BallHamster/ComMANYcator/kicad_bom_export.csv

Generator: | C:\Program Files\KiCad\10.0\bin\scripting\plugins/bom_csv_grouped_by_value_with_fp.py | "" | "" | "" | "" | "" | ""
Component Count: | 41 | "" | "" | "" | "" | "" | ""
Ref | Qnty | Value | Cmp name | Footprint | Description | Vendor | DNP
C1 | 1 | 3,3nF | C | Capacitor_THT:C_Disc_D5.0mm_W2.5mm_P2.50mm | Unpolarized capacitor
C2 | 1 | 10uF | C | Capacitor_THT:CP_Radial_D4.0mm_P2.00mm | Unpolarized capacitor
C3 | 1 | 100nF | C | Capacitor_THT:C_Disc_D5.0mm_W2.5mm_P2.50mm | Unpolarized capacitor
C4 | 1 | 22uF | C | Capacitor_SMD:C_1206_3216Metric | Unpolarized capacitor
C5, C6 | 2 | 4,7 uF | C | Capacitor_THT:CP_Radial_D4.0mm_P2.00mm | Unpolarized capacitor
D1, D2, D3, D4 | 4 | TSAL6100 | TSAL6100 | TSAL6100:LEDRD254W55D595H900 | Infrared (IR) Emitter 940nm 1.35V 100mA 80mW/sr @ 100mA 20° Radial, 5mm Dia (T 1 3/4)
D5, D6 | 2 | TSAL6400 | TSAL6100 | TSAL6100:LEDRD254W55D595H900 | Infrared (IR) Emitter 940nm 1.35V 100mA 80mW/sr @ 100mA 20° Radial, 5mm Dia (T 1 3/4)
J1 | 1 | USB_C_Receptacle_USB2.0_16P | USB_C_Receptacle_USB2.0_16P | Connector_USB:USB_C_Receptacle_HCTL_HC-TYPE-C-16P-01A | USB 2.0-only 16P Type-C Receptacle connector
J2 | 1 | Ext. IR plug | AudioPlug2 | Connector_Audio:Jack_3.5mm_CUI_SJ1-3533NG_Horizontal | Audio Jack, 2 Poles (Mono / TS)
L1 | 1 | 2,2 uH | L | Inductor_SMD:L_Coilcraft_XxL4020 | Inductor
Q1, Q2 | 2 | AO3400A | AO3400A | Package_TO_SOT_SMD:SOT-23 | 30V Vds, 5.7A Id, N-Channel MOSFET, SOT-23
R1, R2, R3, R4, R5, R6, R12 | 7 | 22Ohm | R | Resistor_THT:R_Axial_DIN0207_L6.3mm_D2.5mm_P10.16mm_Horizontal | Resistor
R7 | 1 | 316kOhm | R | Resistor_THT:R_Axial_DIN0207_L6.3mm_D2.5mm_P10.16mm_Horizontal | Resistor
R8, R11, R13 | 3 | 100kOhm | R | Resistor_THT:R_Axial_DIN0207_L6.3mm_D2.5mm_P10.16mm_Horizontal | Resistor
R9, R10 | 2 | 5,1 kOhm | R | Resistor_THT:R_Axial_DIN0207_L6.3mm_D2.5mm_P10.16mm_Horizontal | Resistor
R14, R15 | 2 | 100 Ohm | R | Resistor_THT:R_Axial_DIN0207_L6.3mm_D2.5mm_P10.16mm_Horizontal | Resistor
R16, R17, R18 | 3 | 10 kOhm | R | Resistor_THT:R_Axial_DIN0207_L6.3mm_D2.5mm_P10.16mm_Horizontal | Resistor
U1 | 1 | ESP32-C6-DevKitC-1 | ESP32-C6-DevKitC-1 | PCM_Espressif:ESP32-C6-DevKitC-1 | ESP32-C6-DevKitC-1
U2 | 1 | TSMP58000 | TSMP58000 | OptoDevice:Vishay_MINICAST-3Pin | Photo Module (Amplify&Condition) for PCM Remote Control Systems
U3 | 1 | CC1101 433Mhz module | HW-862_CC1101 | Library:CC1101 RF 433Mhz
U4 | 1 | CC1101 868Mhz module | HW-433_CC1101 | Library:CC1101 RF 833Mhz
U5 | 1 | TSOP38438 | TSOP38438 | OptoDevice:Vishay_MINICAST-3Pin
U6 | 1 | TPS62130 | TPS62130 | Package_DFN_QFN:VQFN-16-1EP_3x3mm_P0.5mm_EP1.68x1.68mm_ThermalVias | 3A Step-Down Converter with DCS-Control, Adjustable Output Voltage, 3-17V Input Voltage, QFN-16
