BallHamster/ComMANYcator/ComMANYcator.kicad_pcb

## KiCad design ComMANYcator.kicad_pcb (2026-10-11)

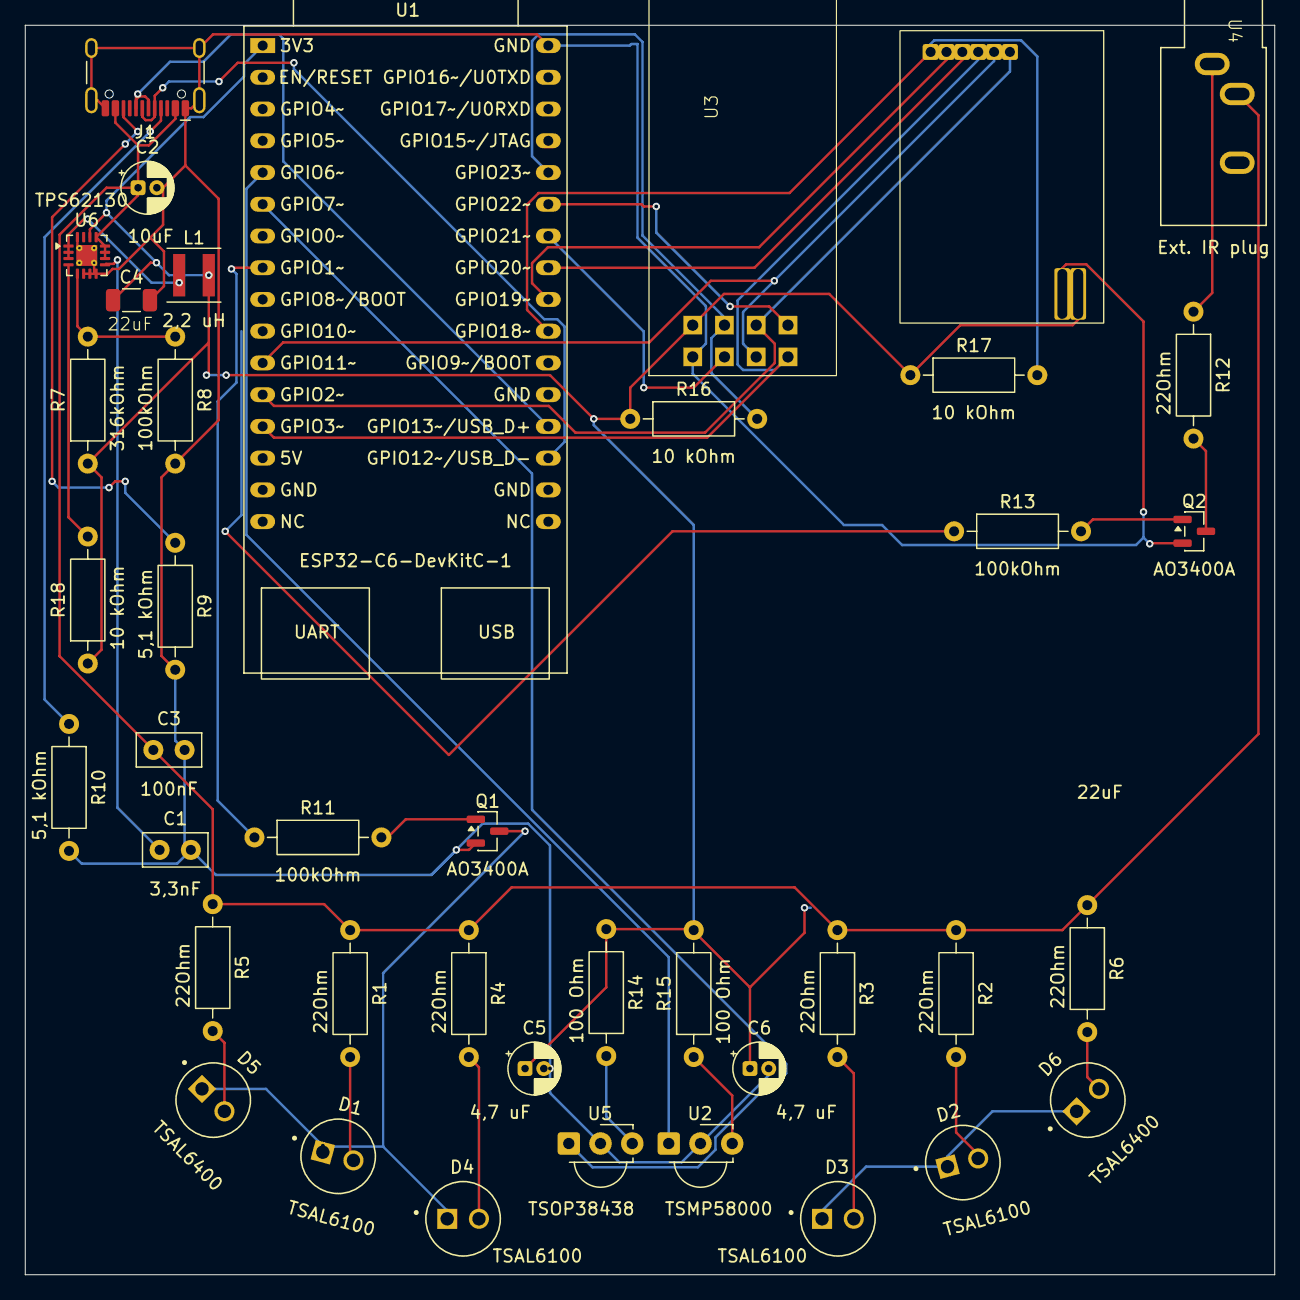
[picture p5: board ComMANYcator.kicad_pcb from above]

Board: 2 copper layers, 100.0 x 100.0 mm, 41 parts (0 on the bottom side), 37 nets.

Parts:
C1: 3,3nF; C_Disc_D5.0mm_W2.5mm_P2.50mm
C2: 10uF; CP_Radial_D4.0mm_P1.50mm
C3: 100nF; C_Disc_D5.0mm_W2.5mm_P2.50mm
C4: 22uF; C_1206_3216Metric
C5, C6: 4,7 uF; CP_Radial_D4.0mm_P1.50mm
D1, D2, D3, D4: TSAL6100; LEDRD254W55D595H900
D5, D6: TSAL6400; LEDRD254W55D595H900
J1: USB_C_Receptacle_USB2.0_16P; USB_C_Receptacle_HCTL_HC-TYPE-C-16P-01A
J2: Ext. IR plug; Jack_3.5mm_CUI_SJ1-3533NG_Horizontal
L1: 2,2 uH; L_Coilcraft_XxL4020
Q1, Q2: AO3400A; SOT-23
R1, R2, R3, R4, R5, R6, R12: 22Ohm; R_Axial_DIN0207_L6.3mm_D2.5mm_P10.16mm_Horizontal
R7: 316kOhm; R_Axial_DIN0207_L6.3mm_D2.5mm_P10.16mm_Horizontal
R8, R11, R13: 100kOhm; R_Axial_DIN0207_L6.3mm_D2.5mm_P10.16mm_Horizontal
R9, R10: 5,1 kOhm; R_Axial_DIN0207_L6.3mm_D2.5mm_P10.16mm_Horizontal
R14, R15: 100 Ohm; R_Axial_DIN0207_L6.3mm_D2.5mm_P10.16mm_Horizontal
R16, R17, R18: 10 kOhm; R_Axial_DIN0207_L6.3mm_D2.5mm_P10.16mm_Horizontal
U1: ESP32-C6-DevKitC-1
U2: TSMP58000; Vishay_MINICAST-3Pin
U3: CC1101 RF 433Mhz
U4: CC1101 RF 833Mhz
U5: TSOP38438; Vishay_MINICAST-3Pin
U6: TPS62130; VQFN-16-1EP_3x3mm_P0.5mm_EP1.68x1.68mm_ThermalVias

Connections:
+3.3V: C4.1, C5.1, C6.1, L1.2, R7.1, R14.1, R15.2, R16.1, R17.1, R18.1, U1.1 (3V3), U3.1 (VCC), U4.7 (VCC), U6.14 (VOS)
+5V: C2.1, C3.1, J1.A4 (VBUS), J1.A9 (VBUS), J1.B4 (VBUS), J1.B9 (VBUS), J2.T, R1.1, R2.1, R3.1, R4.1, R5.1, R6.1, U6.10 (VIN), U6.11 (VIN), U6.12 (VIN), U6.13 (EN)
/MISO: U1.13 (GPIO3), U3.6 (MISO), U4.3 (MISO)
/MOSI: U1.12 (GPIO2), U3.4 (MOSI), U4.1 (MOSI)
/SCK: U1.11 (GPIO11), U3.3 (SCK), U4.2 (SCK)
GND: C1.2, C2.2, C3.2, C4.2, C5.2, C6.2, J1.A1 (GND), J1.A12 (GND), J1.B1 (GND), J1.B12 (GND), J1.SH (SHIELD), Q1.2 (S), Q2.2 (S), R8.2, R9.2, R10.2, U1.32 (GND), U2.2 (GND), U3.5 (GND), U4.8 (GND), U5.2 (GND), U6.6 (GND), U6.7 (FSW), U6.8 (DEF), U6.15 (GND), U6.16 (GND), U6.17 (GND)
unnamed: D1.A, R1.2
unnamed: D2.A, R2.2
unnamed: D3.A, R3.2
unnamed: D4.A, R4.2
unnamed: D5.A, R5.2
unnamed: D6.A, R6.2
unnamed: J1.A5 (CC1), R10.1
unnamed: J1.B5 (CC2), R9.1
unnamed: J2.S, R12.1
unnamed: L1.1, U6.1 (SW), U6.2 (SW), U6.3 (SW)
unnamed: D1.C, D2.C, D3.C, D4.C, D5.C, D6.C, Q1.3 (D)
unnamed: Q1.1 (G), R11.2
unnamed: Q2.3 (D), R12.2
unnamed: Q2.1 (G), R13.2
unnamed: R11.1, U1.8 (GPIO1)
unnamed: U1.5 (GPIO6), U2.1 (OUT)
unnamed: U1.6 (GPIO7), U5.1 (OUT)
unnamed: R13.1, U1.10 (GPIO10)
unnamed: J1.A7 (D-), J1.B7 (D-), U1.19 (GPIO12/USB_D-)
unnamed: J1.A6 (D+), J1.B6 (D+), U1.20 (GPIO13/USB_D+)
unnamed: R17.2, U1.23 (GPIO18), U4.6 (CSN)
unnamed: U1.24 (GPIO19), U4.5 (GDO0)
unnamed: U1.25 (GPIO20), U4.4 (GDO2)
unnamed: U1.26 (GPIO21), U3.7 (GDO0)
unnamed: U1.27 (GPIO22), U3.8 (GDO2)
unnamed: R16.2, U1.28 (GPIO23), U3.2 (CSN)
unnamed: R15.1, U2.3 (Vs)
unnamed: R14.2, U5.3 (VS)
unnamed: R7.2, R8.1, U6.5 (FB)
unnamed: R18.2, U6.4 (PG)
unnamed: C1.1, U6.9 (SS/TR)
