BallHamster/ComMANYcator/(commit log)

2026-10-11 Main push
    [ComMANYcator.kicad_pcb, ComMANYcator.kicad_sch, untitled.csv]
2026-10-11 Update CSV file with new component data
    [untitled.csv]
2026-10-11 Update component details in untitled.csv
    [untitled.csv]
2026-10-11 Fix formatting issues in untitled.csv
    [untitled.csv]
2026-10-11 Rename FINAL WIRE.png to images/FINAL WIRE.png
2026-10-11 Rename Képernyőkép 2026-10-09 192011.png to images/led layout
2026-10-11 Rename PCB FINAL.png to images/PCB FINAL.png
2026-10-11 Rename CC1101 RF 433Mhz.kicad_mod to mods/CC1101 RF 433Mhz.kicad_mod
2026-10-11 Rename CC1101 RF 833Mhz.kicad_mod to mods/CC1101 RF 833Mhz.kicad_mod
2026-10-11 Revise README with schematic and PCB layout details
    Updated section titles and added schematic and PCB layout images.
2026-10-11 Rename led layout to led layout.png
2026-10-11 Add initial configuration for ESP32-C6 device
    This configuration file sets up an ESP32-C6 device with various components including WiFi, remote transmitters, and receivers for IR and RF signals.
2026-10-11 Add BOM with electronic components details
    Added bill of materials with various electronic components including their specifications and links.
    [bom.csv]
2026-10-11 Remove extra comma from bom.csv header
    [bom.csv]
2026-10-11 Add price column to BOM CSV
    Added price information for each component in bom.csv.
    [bom.csv]
2026-10-11 Add BOM section with component details
    Added a Bill of Materials (BOM) section with details on components, including reference numbers, part types, quantities, minimum orders, importers, MPNs, links, and prices.
2026-10-22 Rename mods/CC1101 RF 433Mhz.kicad_mod to kicad_files/mods/CC1101 RF 433Mhz.kicad_mod
2026-10-22 Rename mods/CC1101 RF 833Mhz.kicad_mod to kicad_files/mods/CC1101 RF 833Mhz.kicad_mod
2026-10-22 Update LEDRD254W55D595H900.kicad_mod file
2026-10-22 Update TSOP_4PIN_VIS.kicad_mod file
2026-10-22 Update kicad_sym file
2026-10-22 Fix formatting in bom.csv for total cost line
    [bom.csv]
2026-10-22 Fix total cost formatting in bom.csv
    [bom.csv]
